Jowllel/Wireless-ScoreBoard-Display/5_Hardware/WSBD_Board/Project Outputs for WSBD_Board/WSBD_Board.pdf

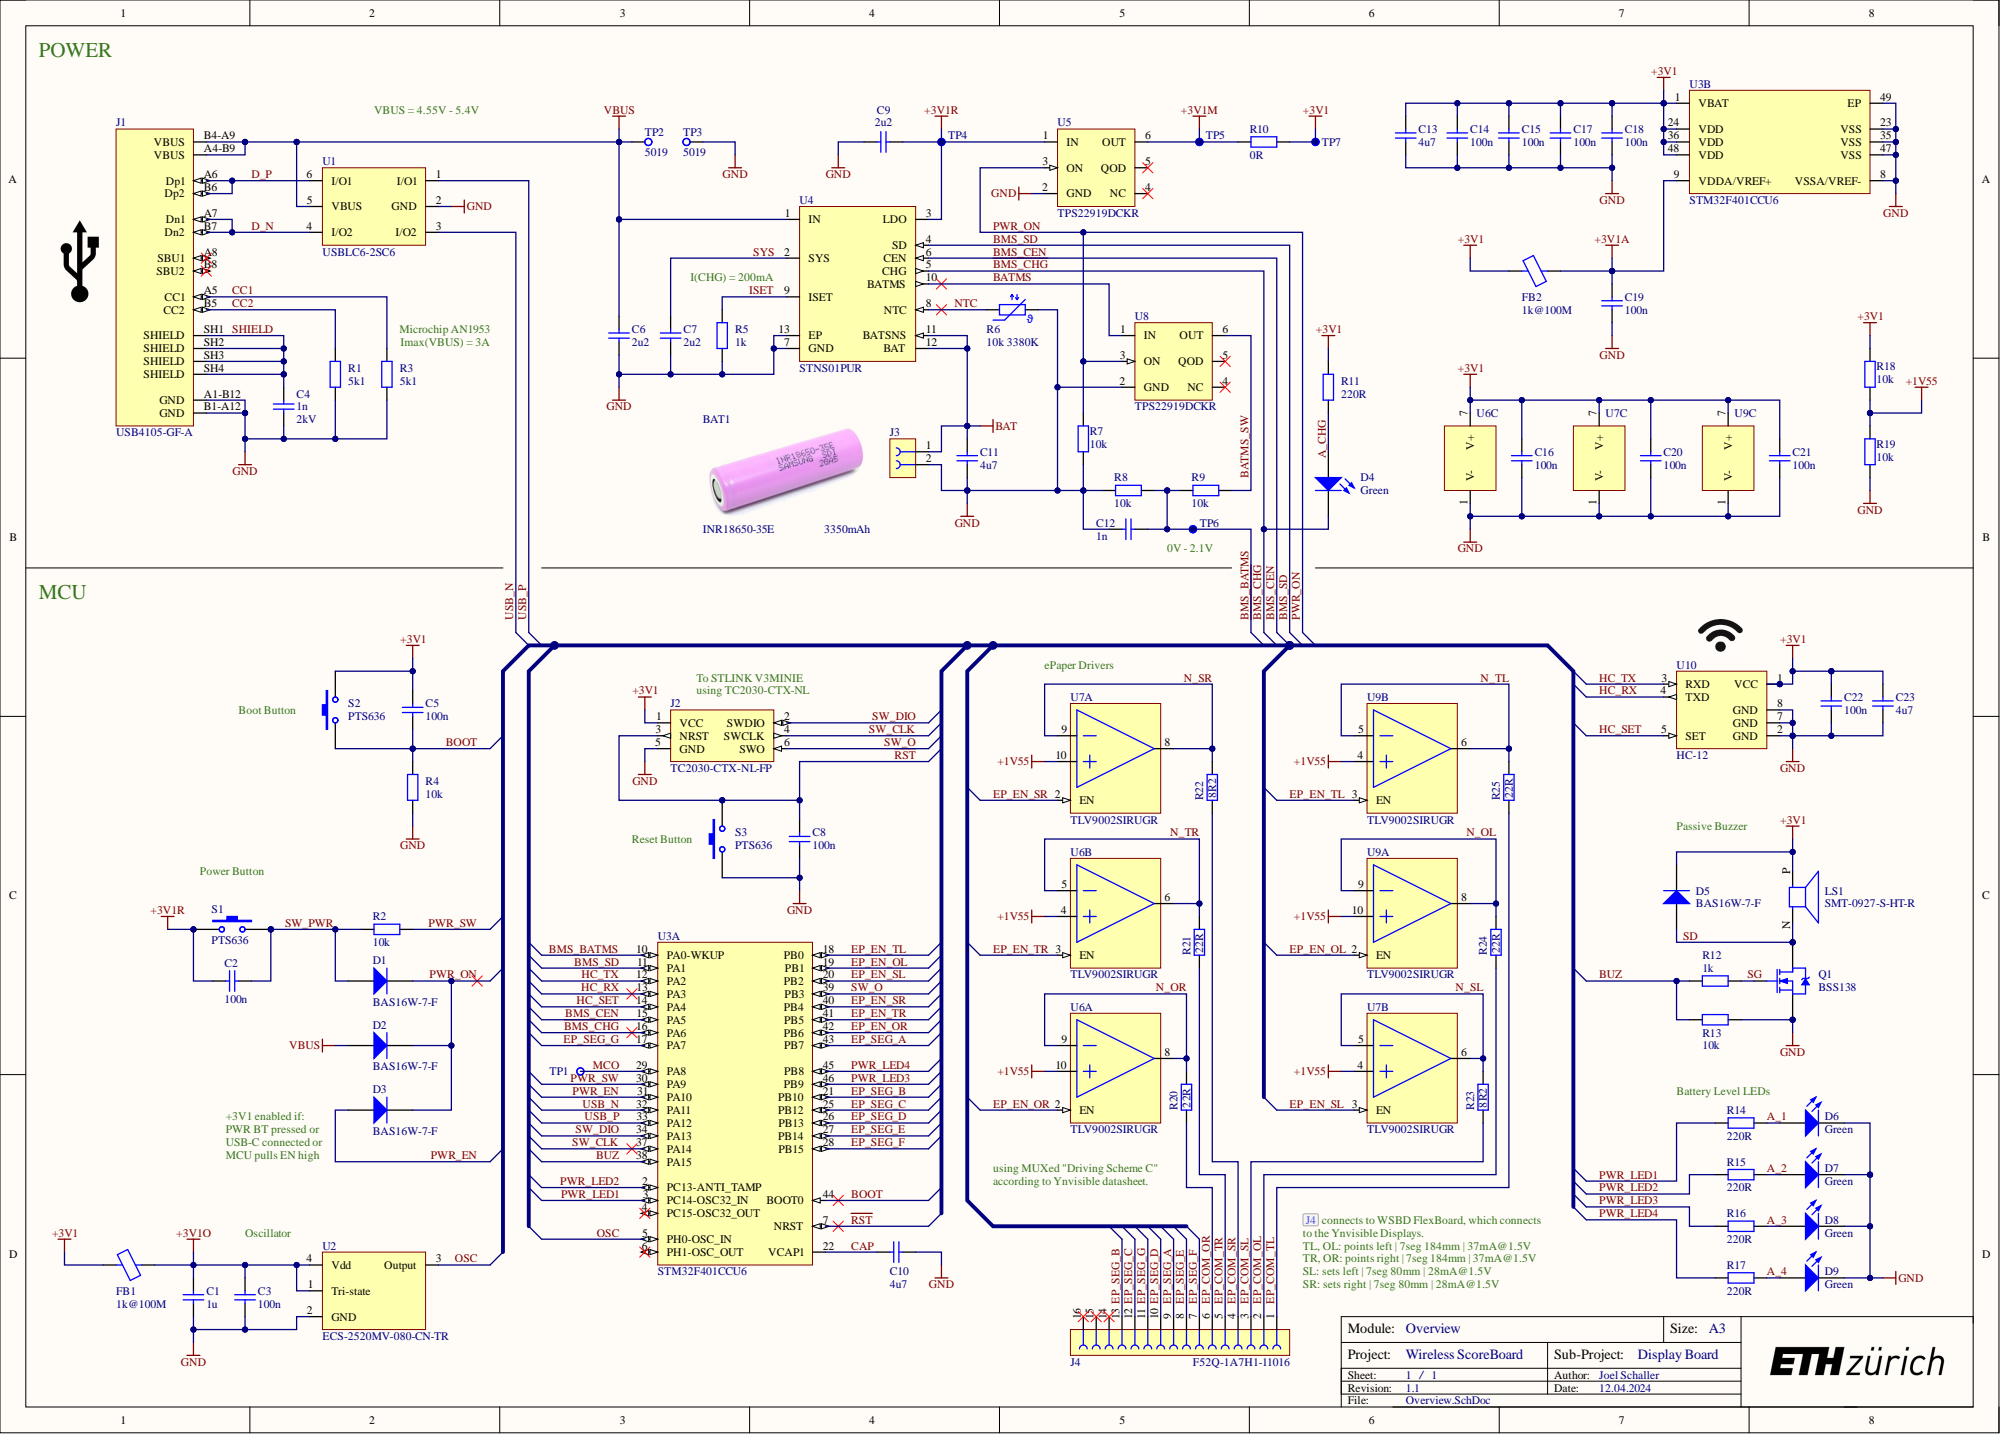
[picture p2: page 1]

+3V1 enabled if:
PWR BT pressed or
USB-C connected or
MCU pulls EN high

using MUXed "Driving Scheme C"
according to Ynvisible datasheet.

J4 connects to WSBD FlexBoard, which connects
to the Ynvisible Displays.
TL, OL: points left | 7seg 184mm | 37mA@1.5V
TR, OR: points right | 7seg 184mm | 37mA@1.5V
SL: sets left | 7seg 80mm | 28mA@1.5V

Project: Wireless ScoreBoard | Sub-Project: DisplayBoard

Sheet: 1 / 1 | Author: Joel Schaller
Revision: 1.1 | Date: 12.04.2024

Fitted | Designator | Comment | Value | Description | Manufacturer | ManufacturerPart Number | Supplier | SupplierPart Number | Quantity
Fitted | BAT1 | INR18650-35E | 3350mAh | EMECHSINGLE BATTERYLIPO | Samsung | INR18650-35E | Conrad | 1499572- 62 | 1
Fitted | C1 | C0805 | 1u | CERCAP1u25V10% X7R0805 | YAGEO | CC0805KKX7R8BB105 | Digi-Key | 311-1456-1-ND | 1
Fitted | C2, C3, C5, C8, C14, C15, C16, C17, C18, C19, C20, C21, C22 | C0402 | 100n | CERCAP100n50V10% X7R0402 | YAGEO | CC0402KRX7R9BB104 | Digi-Key | 311-3566-1-ND | 13
Fitted | C4 | C1206 | 1n | CERCAP1n2kV10% X7R1206 | WürthElektronik | 885342208024 | Digi-Key | 732-885342208024CT-ND | 1
Fitted | C6, C7, C9 | C0805 | 2u2 | CERCAP2u225V10% X7R0805 | YAGEO | CC0805KKX7R8BB225 | Digi-Key | 311-1884-1-ND | 3
Fitted | C10, C11, C13, C23 | C0805 | 4u7 | CERCAP4u725V10% X7R0805 | YAGEO | CC0805KKX7R8BB475 | Digi-Key | 311-1885-1-ND | 4
Fitted | C12 | C0402 | 1n | CERCAP1n50V10% X7R0402 | YAGEO | CC0402KRX7R9BB102 | Digi-Key | 311-1036-1-ND | 1
Fitted | D1, D2, D3, D5 | BAS16W-7-F | | DIODE200mW75V 300mASOT-323 | DiodesIncorporated | BAS16W-7-F | Digi-Key | BAS16W-FDICT-ND | 4
Fitted | D4, D6, D7, D8, D9 | APHHS1005LZGCK-V | Green | LEDGREEN2mA2.65V 0402 | Kingbright | APHHS1005LZGCK-V | DigiKey | 754-2126-1-ND | 5
Fitted | FB1, FB2 | BLM15BD102SN1D | 1k@100M | FERRITE200mA-1k 0402 | MurataElectronics | BLM15BD102SN1D | Digi-Key | 490-1010-1-ND | 2
Fitted | J1 | USB4105-GF-A | | CONNFemaleUSB-C 16xHorizontal SMD | GCT | USB4105-GF-A | Digi-Key | 2073-USB4105-GF-ACT-ND | 1
Fitted | J4 | F52Q-1A7H1-11016 | | CONNFPCTOP16POS 1mm | Amphenol ICC(FCI) | F52Q-1A7H1-11016 | Digi-Key | 609-F52Q-1A7H1-11016CT-ND | 1
Fitted | LS1 | SMT-0927-S-HT-R | | PASSIVE PIEZO_BUZZER 8.5x8.5x4.3mm | PUIAudio, Inc. | SMT-0927-S-HT-R | Digi-Key | 668-SMT-0927-S-HT-RCT-ND | 1
Fitted | Q1 | BSS138 | | MOSFETN0.2A50V SOT323 | DiodesIncorporated | BSS138W-7-F | Digi-Key | BSS138W-FDICT-ND | 1
Fitted | R1, R3 | R0402 | 5k1 | RES5k162.5mW1% 0402 | YAGEO | RC0402FR-075K1L | Digi-Key | 311-5.10KLRCT-ND | 2
Fitted | R2, R4, R7, R8, R9, R13, R18, R19 | R0402 | 10k | RES10k62.5mW1% 0402 | YAGEO | RC0402FR-0710KL | Digi-Key | 311-10.0KLRCT-ND | 8
Fitted | R5, R12 | R0402 | 1k | RES1k62.5mW1% 0402 | YAGEO | RC0402FR-071KL | Digi-Key | 311-1.00KLRCT-ND | 2
Fitted | R6 | NCU15XH103F6SRC | 10k3380K | RESNTC10k3380K | MurataElectronics | NCU15XH103F6SRC | Digi-Key | 490-NCU15XH103F6SRCC T-ND | 1
Fitted | R10 | R0402 | 0R | RES0R0402 | YAGEO | RC0402FR-070RL | Digi-Key | 311-0.0LRCT-ND | 1
Fitted | R11, R14, R15, R16, R17 | R0402 | 220R | RES220R62.5mW1% 0402 | YAGEO | RC0402FR-07220RL | Digi-Key | 311-220LRCT-ND | 5
Fitted | R20, R21, R24, R25 | R0402 | 22R | RES22R62.5mW1% 0402 | YAGEO | RC0402FR-0722RL | Digi-Key | 311-22.0LRCT-ND | 4
Fitted | R22, R23 | R0402 | 8R2 | RES8R262.5mW1% 0402 | YAGEO | RC0402FR-078R2L | Digi-Key | 13-RC0402FR-078R2LCT-ND | 2
Fitted | S1, S2, S3 | PTS636 | | BUTTONSPST12V 50mA6x3.5x4.3mm | C&K | PTS636SK43SMTR LFS | Digi-Key | CKN12311-1-ND | 3
Fitted | TP2, TP3 | 5019 | | TPSMD3.81x2.03mm | KeystoneElectronics | 5019 | Digi-Key | 36-5019CT-ND | 2
Fitted | U1 | USBLC6-2SC6 | | ICDual ESDProtection SOT23-6 | STMicroelectronics | USBLC6-2SC6 | Digi-Key | 497-5235-1-ND | 1
Fitted | U2 | ECS-2520MV-080-CN-TR | | OSC8MHz Enable/Disable1.6V-3.6V4-SMD2.5x2mm | ECSInc. | ECS-2520MV-080-CN-TR | Digi-Key | XC3029CT-ND | 1
Fitted | U3 | STM32F401CCU6 | | MCUARM-Cortex-M4 256kB_FLASH 64kB_RAM1.7-3.6V UFQFPN48 | STMicroelectronics | STM32F401CCU6 | Digi-Key | 497-17426-ND | 1
Fitted | U4 | STNS01PUR | | ChargerSingleLiIon 5.4V12-DFN | STMicroelectronics | STNS01PUR | Digi-Key | 497-13880-1-ND | 1
Fitted | U5, U8 | TPS22919DCKR | | POWER-DISTRIBUTION SingleSwitch5.5V SOT363 | TexasInstruments | TPS22919DCKR | Digi-Key | 296-TPS22919DCKRCT-ND | 2
Fitted | U6, U7, U9 | TLV9002SIRUGR | | OPAMPDUAL1MHz1.8-5.5VX2QFN | TexasInstruments | TLV9002SIRUGR | Digi-Key | 296-TLV9002SIRUGRCT-ND | 3
Fitted | U10 | HC-12 | | RFModuleUART | HCTech | HC-12 | AliExpress | HC-12 | 1

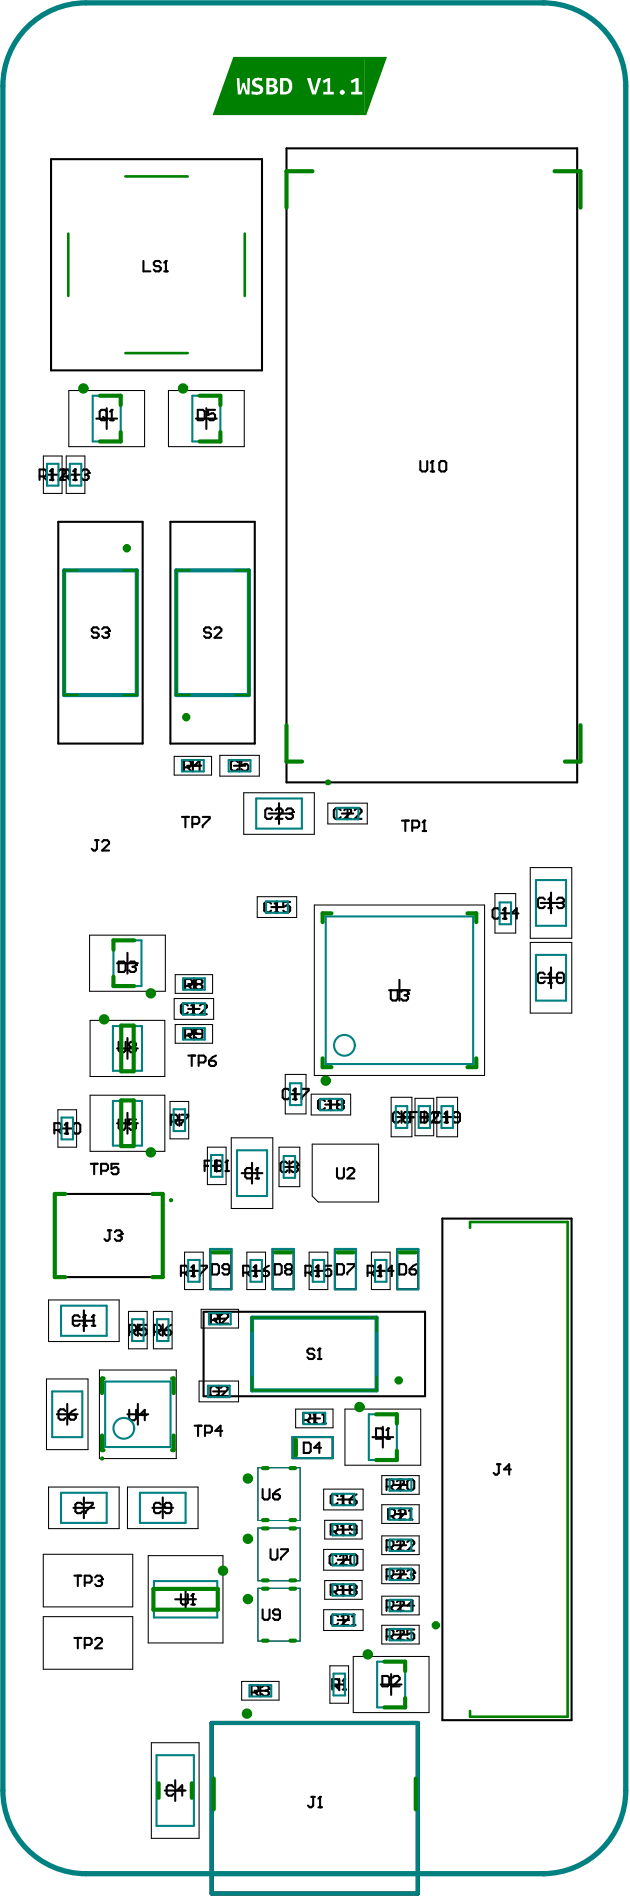
[picture p3: page 3]

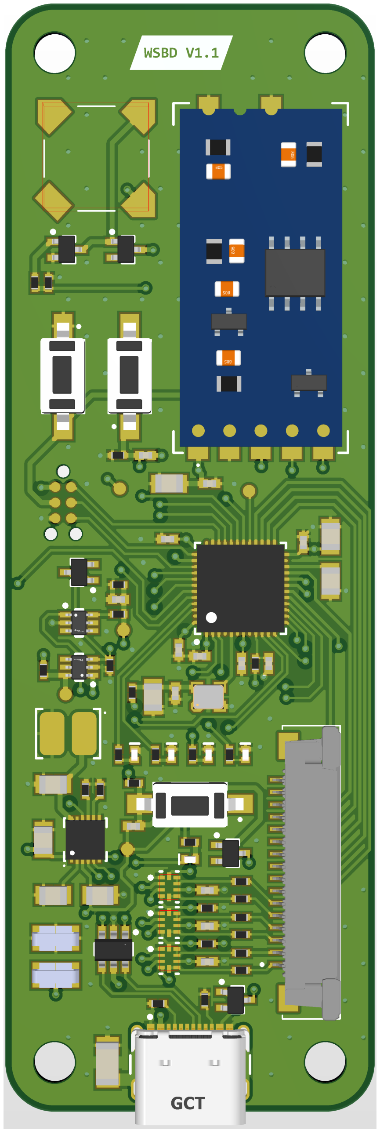
[picture p4: figure]

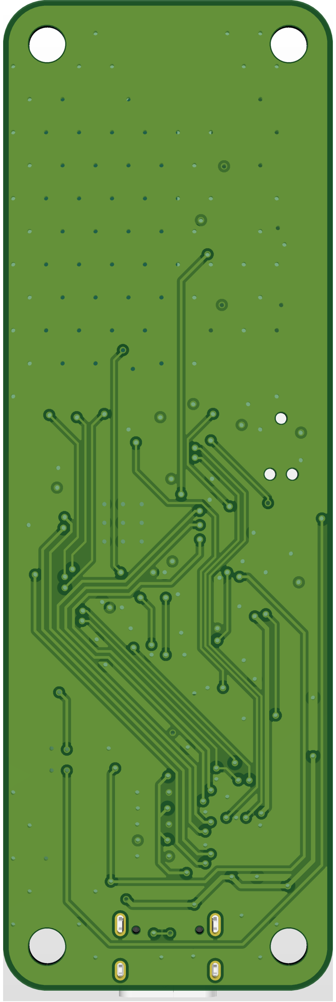
[picture p5: figure]
