Jowllel/Wireless-ScoreBoard-Display/5_Hardware/WSBD_FlexBoard/Project Outputs for WSBD_FlexBoard/Bill of Materials/Bill of Materials-WSBD_FlexBoard.xlsx

Fitted | Designator | Comment | Value | Description | Manufacturer | Manufacturer Part Number | Supplier | Supplier Part Number | Quantity
Fitted | J2, J3, J4, J5 | F52R-1A7H1-11008 |  | CONN FPC TOP 8POS 1mm | Amphenol ICC (FCI) | F52R-1A7H1-11008 | Digi-Key | 609-F52R-1A7H1-11008CT-ND | 4
Fitted | J6 | F52Q-1A7H1-11016 |  | CONN FPC TOP 16POS 1mm | Amphenol ICC (FCI) | F52Q-1A7H1-11016 | Digi-Key | 609-F52Q-1A7H1-11016CT-ND | 1
Fitted | MEC1, MEC4 | Ynvisible 7Seg 80mm |  | EMECH SINGLE EPAPER 7SEG 80MM | Ynvisible | LARGE E-PAPER DISPLAY – SINGLE DIGIT 80MM | Ynvisible Shop | SINGLE DIGIT 80MM | 2
Fitted | MEC2, MEC3 | Ynvisible 7Seg 184mm |  | EMECH SINGLE EPAPER 7SEG 184MM | Ynvisible | LARGE E-PAPER DISPLAY – SINGLE DIGIT 184MM | Ynvisible Shop | SINGLE DIGIT 184MM | 2
