Jowllel/Wireless-ScoreBoard-Display/2_Documentation/HW_Concept/HW_Concept_WSB_Display.drawio.pdf

## Hardware Concept WSBD Board

## LiIon Battery

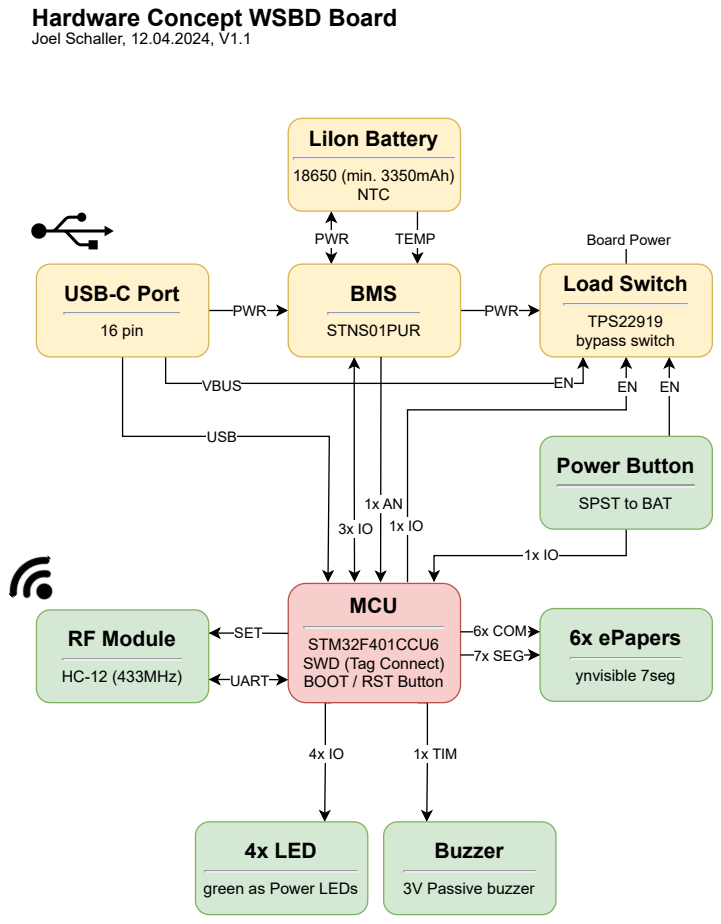
[picture p6: page 1]
Joel Schaller, 12.04.2024, V1.1; 1x TIM; MCU; Power Button; 4x LED; Buzzer; 3V Passive buzzer; PWR; TEMP; 18650 (min. 3350mAh) NTC; USB; VBUS; USB-C Port; 16 pin; BMS; STNS01PUR; Board Power; Load Switch; TPS22919 bypass switch; RF Module; HC-12 (433MHz); UARSPIT; SET; 6x ePapers; ynvisible 7seg; 6x COM; 7x SEG

SPST to BAT

STM32F401CCU6
SWD (Tag Connect)
BOOT / RST Button

green as Power LEDs
