Jowllel/Wireless-ScoreBoard-Display/5_Hardware/WSBD_FlexBoard/Project Outputs for WSBD_FlexBoard/WSBD_FlexBoard.pdf

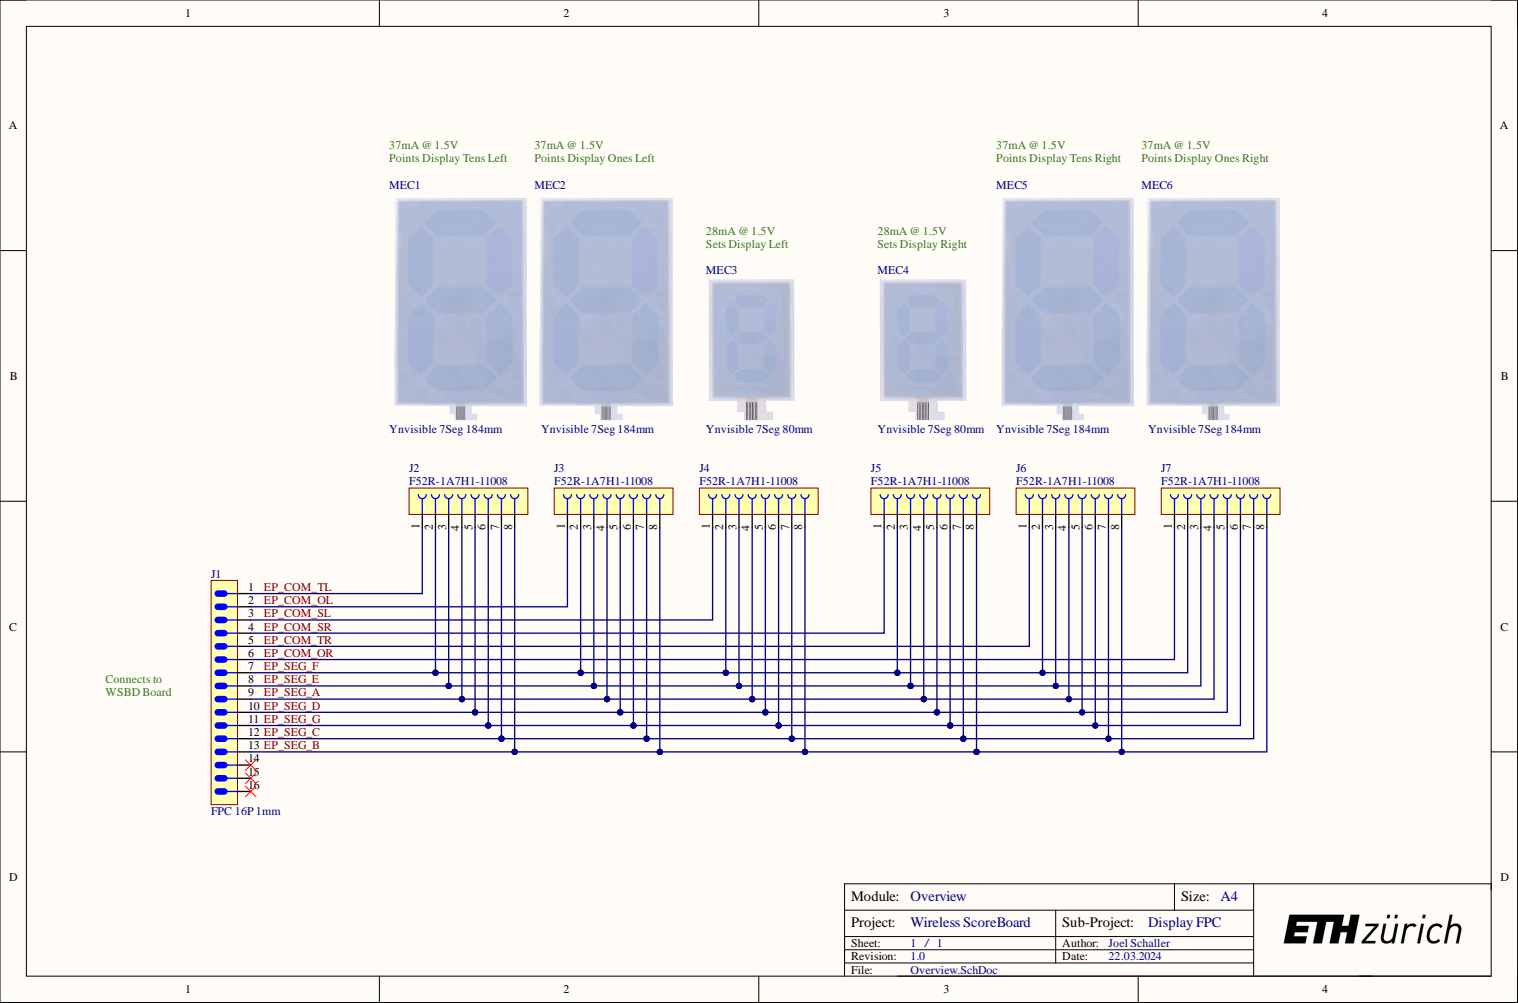
[picture p7: page 1]

Project: Wireless ScoreBoard | Sub-Project: Display FPC

Sheet: 1 / 1 | Author: Joel Schaller
Revision: 1.0 | Date: 22.03.2024

Fitted | Designator | Comment | Value | Description | Manufacturer | ManufacturerPart Number | Supplier | SupplierPart Number | Quantity
Fitted | J2, J3, J4, J5, J6, J7 | F52R-1A7H1-11008 | | CONNFPCTOP8POS 1mm | Amphenol ICC(FCI) | F52R-1A7H1-11008 | Digi-Key | 609-F52R-1A7H1-11008CT-ND | 6
Fitted | MEC1, MEC2, MEC5, MEC6 | Ynvisible7Seg184mm | | EMECHSINGLE EPAPER7SEG184MM | Ynvisible | LARGEE-PAPER DISPLAY–SINGLE DIGIT184MM | YnvisibleShop | SINGLEDIGIT184MM | 4
Fitted | MEC3, MEC4 | Ynvisible7Seg80mm | | EMECHSINGLE EPAPER7SEG80MM | Ynvisible | LARGEE-PAPER DISPLAY–SINGLE DIGIT80MM | YnvisibleShop | SINGLEDIGIT80MM | 2
