Jowllel/Wireless-ScoreBoard-Display/4_Resources/F52Q-1A7H1-11016.pdf

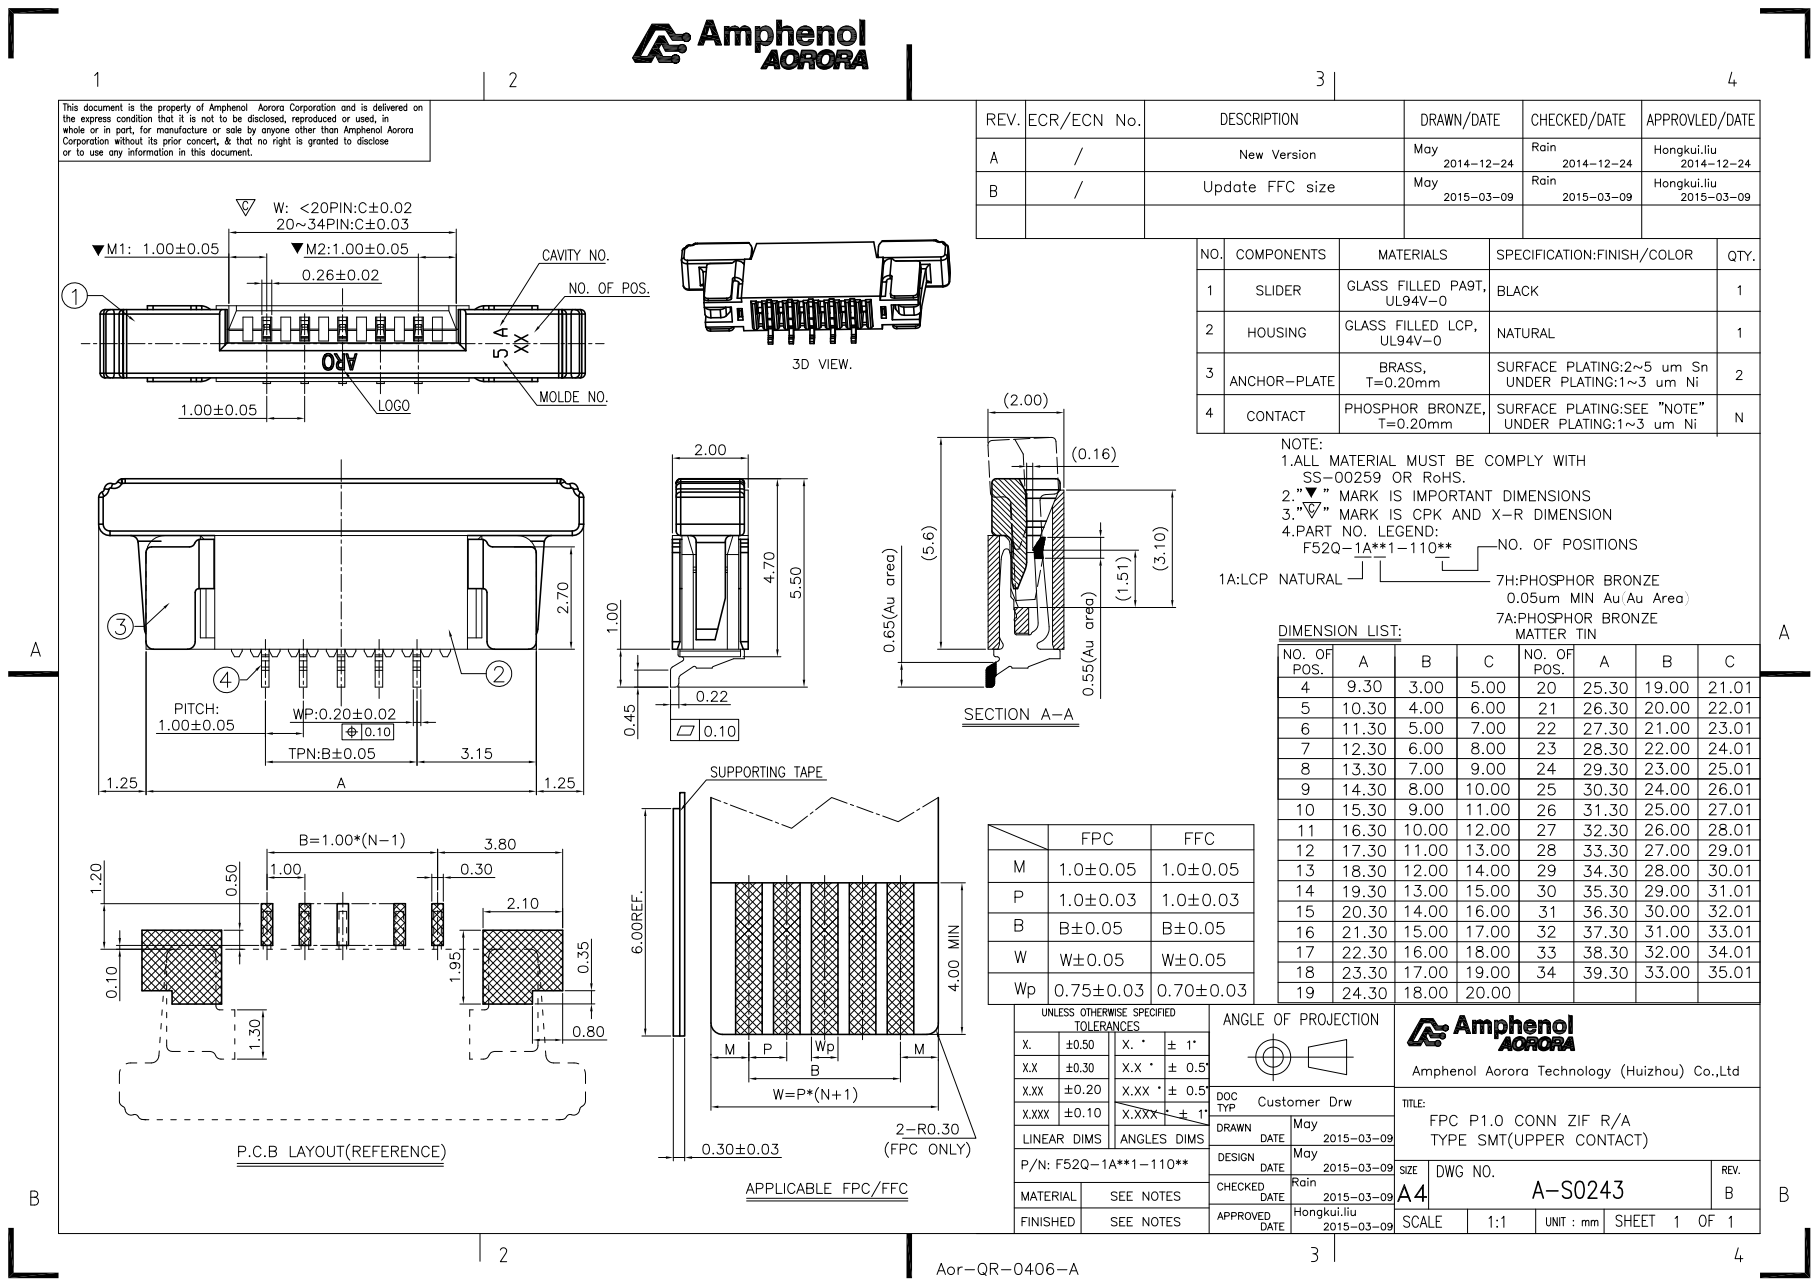
[picture p8: page 1]
