Jowllel/Wireless-ScoreBoard-Display/4_Resources/F52R-1A7H1-11008_DWG.pdf

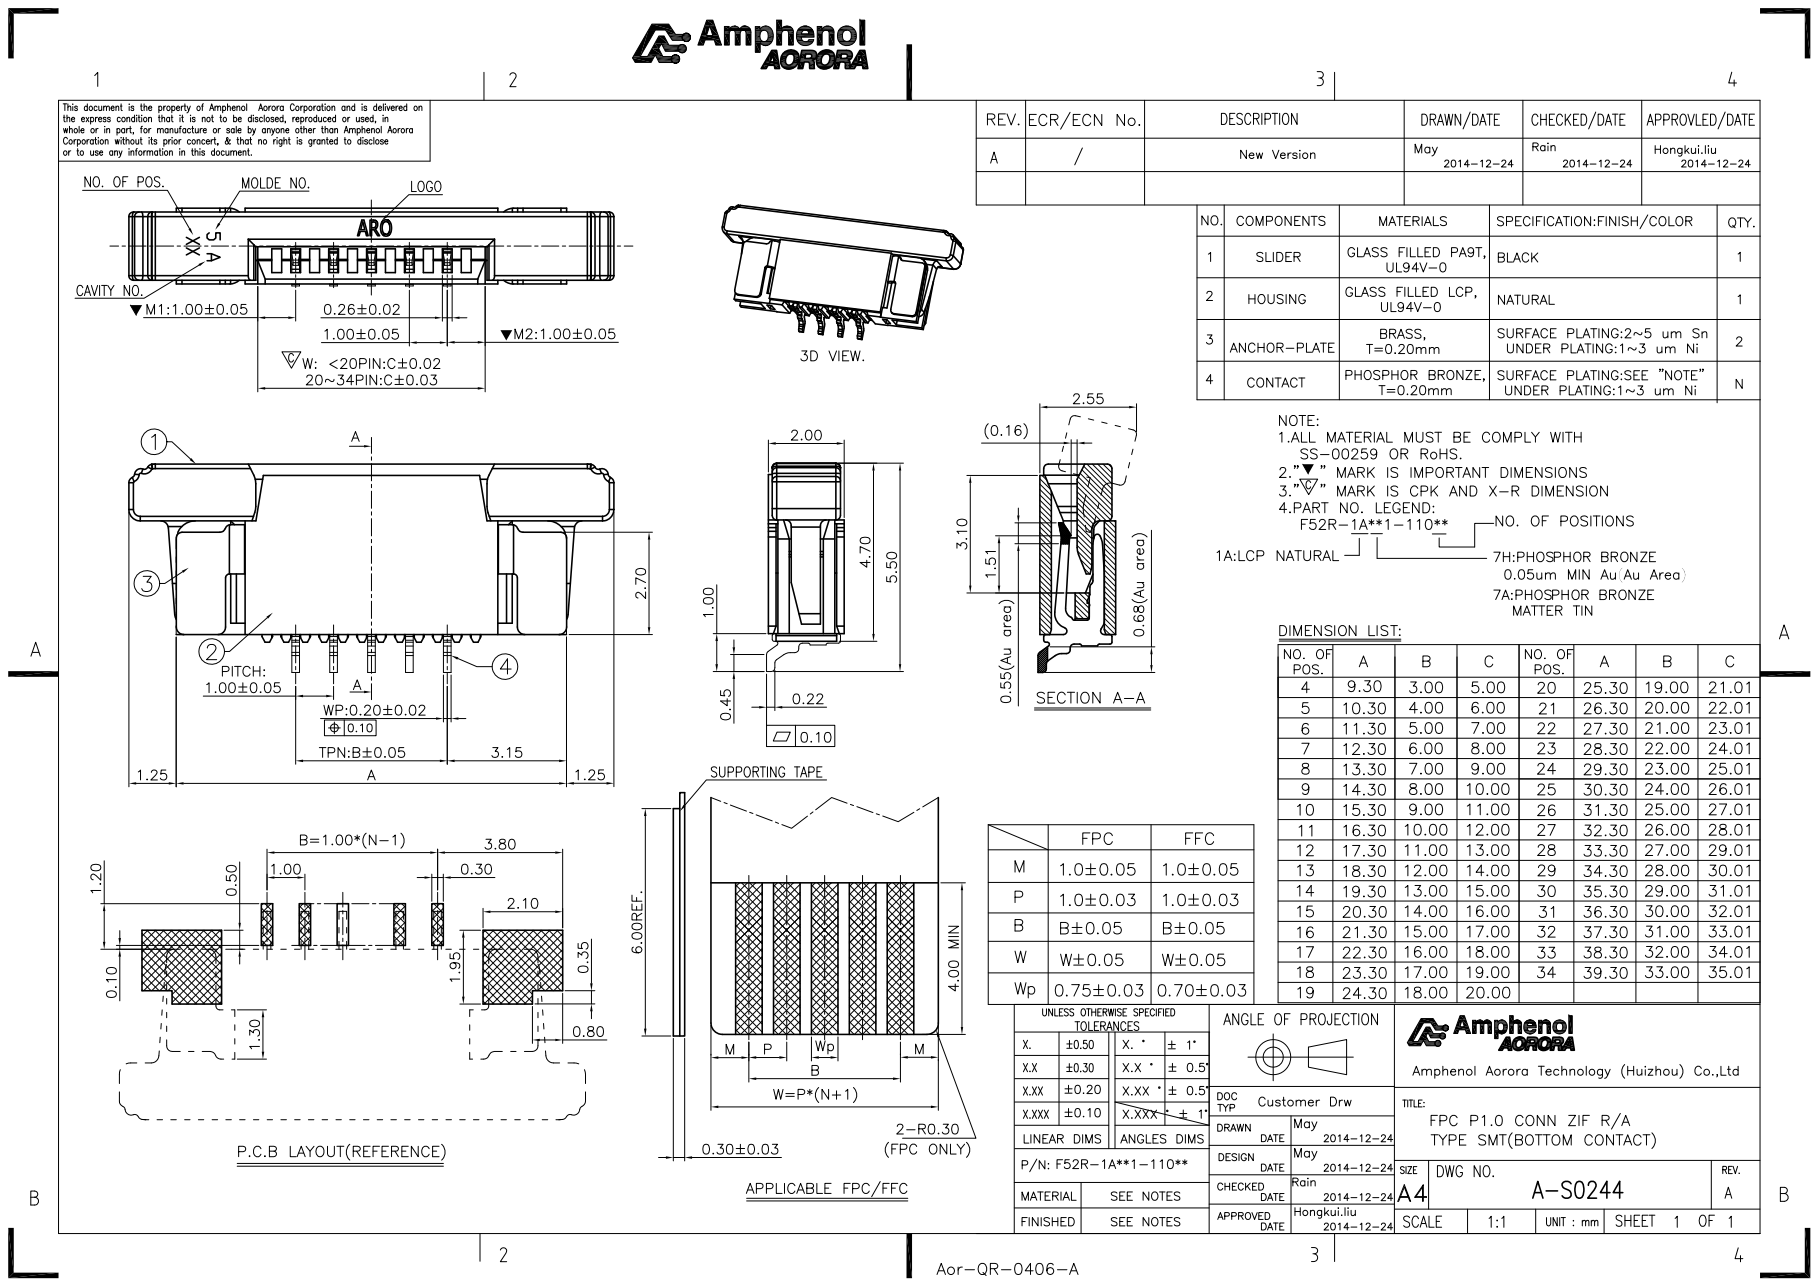
[picture p9: page 1]
