Jowllel/Wireless-ScoreBoard-Display/(list of files, drawings)

Other design files:
5_Hardware/WSBD_Board/Overview.SchDoc
5_Hardware/WSBD_Board/WSBD_Board.PrjPcb
5_Hardware/WSBD_FlexBoard/Overview.SchDoc
5_Hardware/WSBD_FlexBoard/WSBD_FlexBoard.PcbDoc
5_Hardware/WSBD_FlexBoard/WSBD_FlexBoard.PrjPcb
