Jowllel/Wireless-ScoreBoard-Display/5_Hardware/WSBD_Board/Project Outputs for WSBD_Board/PCB 3D Print BOT/WSBD_Board.png

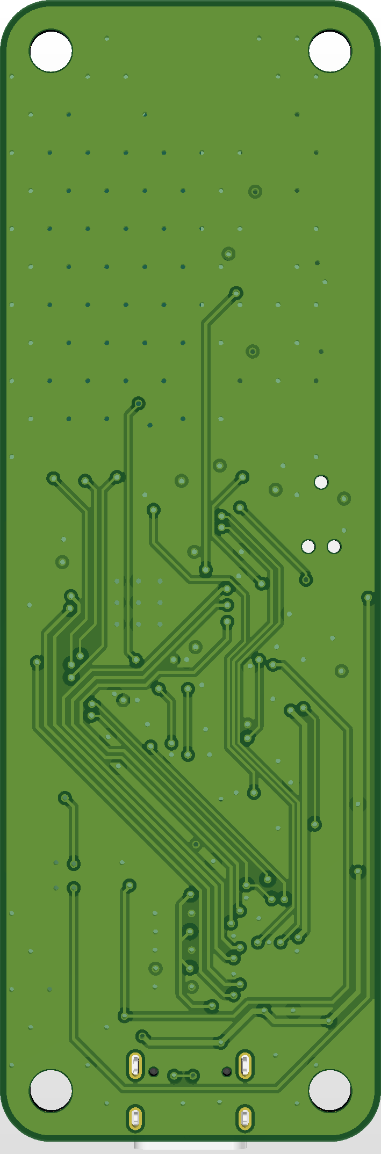
5_Hardware/WSBD_Board/Project Outputs for WSBD_Board/PCB 3D Print BOT/WSBD_Board.png
