Jowllel/Wireless-ScoreBoard-Display/5_Hardware/WSBD_FlexBoard/Project Outputs for WSBD_FlexBoard/PCB 3D Print TOP/WSBD_FlexBoard.png

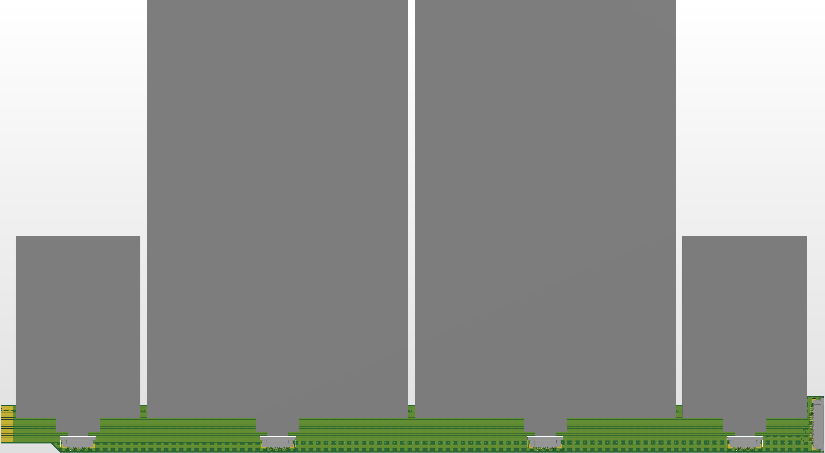
5_Hardware/WSBD_FlexBoard/Project Outputs for WSBD_FlexBoard/PCB 3D Print TOP/WSBD_FlexBoard.png
