Jowllel/Wireless-ScoreBoard-Display/(commit log)

2024-03-17 Added Altium Project, using Remote as template.
    [Overview.SchDoc, WSBD_Board.PrjPcb]
2024-03-17 start schematics. (removed: acc, buttons, rgb led | Added: Display OPAmps)
    [Overview.SchDoc, WSBD_Board.PrjPcb]
2024-03-17 DS changes according to schematics.
2024-03-18 Schematics done. (self review)
    [Overview.SchDoc]
2024-03-20 WSBD Schematics ready for external review.
    [Bill of Materials-WSBD_Board.xlsx, Overview.SchDoc, WSBD_Board.PrjPcb]
2024-03-20 Started Altium FPC Project.
    [Overview.SchDoc, WSBD_FlexBoard.PcbDoc, WSBD_FlexBoard.PrjPcb]
2024-03-22 WSBD FlexBoard schematics done.
    [Bill of Materials-WSBD_FlexBoard.xlsx, Overview.SchDoc, WSBD_FlexBoard.PcbDoc, WSBD_FlexBoard.PrjPcb]
2024-03-22 Added FPC connector datasheets.
2024-03-23 WSBD Flex done.
    [Bill of Materials-WSBD_FlexBoard.xlsx, Overview.SchDoc, WSBD_FlexBoard.PcbDoc, WSBD_FlexBoard.PrjPcb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]
2024-03-29 Added WSBD Board Review V1.0
2024-03-30 WSBD Layout wip.
    [Overview.SchDoc, WSBD_Board.PrjPcb]
2024-03-30 WSBD ready to order.
    [Bill of Materials-WSBD_Board.xlsx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]
2024-04-12 WSBD V1.1
    [WSBD_Board.PrjPcb]
